Normansrule/riscv-64-instruction-cpu/binary/Zbb/cpopw.md

# `cpopw`: Count Population Word

[← all instructions](../README.md) · extension **Zbb** · format **I-unary** · category *Bit manipulation*

```
rd = number of 1 bits in rs1[31:0]
```

## Encoding

cpopw encoding

```
bit:  31                              0
      0110 0000 0010 ssss s001 dddd d001 1011
```

Fixed bits are `0`/`1`. Letters are filled in by the assembler:
`d` = rd, `s` = rs1, `t` = rs2, `i` = immediate, `h` = shift amount, `c` = CSR address, `z` = 5-bit CSR immediate, `f` = funct3, `m/p/u` = fence fields.

## Example

`cpopw a0, a1` assembles to **`0x6025951b`** = `01100000001001011001010100011011`

example

| field | bits | template | example |
|---|---|---|---|
| `funct12` | 31:20 | `011000000010` | `011000000010` |
| `rs1` | 19:15 | `sssss` | `01011` |
| `funct3` | 14:12 | `001` | `001` |
| `rd` | 11:7 | `ddddd` | `01010` |
| `opcode` | 6:0 | `0011011` | `0011011` |

Try it yourself:

```bash
node tools/rv.mjs encode "cpopw a0, a1"
node tools/rv.mjs decode 6025951b
```

## Control signals from the Control Unit ([`src/Control_Unit.sv`](../../src/Control_Unit.sv))

These are the exact values the RTL produces for the example word above (computed by the
bit-exact twin in `model/core.js`, which `make test` checks against the RTL every cycle).

| signal | value | | signal | value |
|---|---|---|---|---|
| `REGISTER_WRITE_ENABLE` | `1` | | `IS_A_MULTIPLY_DIVIDE_INSTRUCTION` | `0` |
| `MEMORY_READ_ENABLE` | `0` | | `IS_A_BRANCH_INSTRUCTION` | `0` |
| `MEMORY_WRITE_ENABLE` | `0` | | `IS_A_JAL_INSTRUCTION` | `0` |
| `CSR_WRITE_ENABLE` | `0` | | `IS_A_JALR_INSTRUCTION` | `0` |
| `CSR_WRITE_USING_IMMEDIATE` | `0` | | `IMMEDIATE_TYPE_SELECT` | `IMMEDIATE_I` |
| `ALU_INPUT_A_IS_PC` | `0` | | `WRITEBACK_SELECT` | `WRITEBACK_ALU` |
| `ALU_INPUT_B_IS_IMMEDIATE` | `1` | | `ALU_OPERATION` | `ALU_CPOP` |
| `ALU_IS_WORD_OPERATION` | `1` | |  |  |

## Journey through the 6-stage pipeline

| stage | what happens to `cpopw` |
|---|---|
| **FETCH1** | The PC is sent to the instruction memory. At the same time the **GSharePredictor** reads the 2-bit counter at `PC[5:2] XOR GLOBAL_HISTORY_REGISTER` (it does not know yet what instruction this is). |
| **FETCH2** | The 32-bit word arrives from memory. It is not a branch or JAL, so fetching simply continues at `PC + 4`. |
| **DECODE** | **ControlUnit** + **ALUdec** recognise `cpopw` from opcode `0011011`, funct3 `001`, funct12 `011000000010`; the **ImmediateGenerator** builds the I-type immediate. The **RegisterFile** is read for `rs1`, and the forwarding muxes replace a stale value with a newer one from EXECUTE, MEMORY or WRITEBACK. |
| **EXECUTE** | The **ALU** performs `CPOP` on the low 32 bits and sign-extends the result to 64 bits: `rd = number of 1 bits in rs1[31:0]`. This result is one of the two-cycle ones (`EXECUTE_LATE_RESULT`): it is forwarded from MEMORY, so an instruction that needs it right away waits one cycle. |
| **MEMORY** | No memory work. **WriteControl** picks the `WRITEBACK_ALU` value, which can be forwarded back to DECODE. |
| **WRITEBACK** | The **RegisterFile** writes `rd` at the clock edge (ignored if `rd` is `x0`). The instruction is now **retired** and the `instret` counter goes up by one. |

See the whole datapath in the [block diagram](../../docs/ARCHITECTURE.md) and step through a program in the [web simulator](../../web/index.html).
