Normansrule/riscv-64-instruction-cpu/binary/Priv/mret.md

# `mret`: Machine-mode Return

[← all instructions](../README.md) · extension **Priv** · format **SYS** · category *System*

```
return from a trap: pc = mepc, mstatus.MIE = mstatus.MPIE
```

## Encoding

mret encoding

```
bit:  31                              0
      0000 0000 0000 0000 0000 0000 0111 0011
```

Fixed bits are `0`/`1`. Letters are filled in by the assembler:
`d` = rd, `s` = rs1, `t` = rs2, `i` = immediate, `h` = shift amount, `c` = CSR address, `z` = 5-bit CSR immediate, `f` = funct3, `m/p/u` = fence fields.

## Example

`mret` assembles to **`0x30200073`** = `00110000001000000000000001110011`

example

| field | bits | template | example |
|---|---|---|---|
| `funct12` | 31:20 | `000000000000` | `001100000010` |
| `rs1` | 19:15 | `00000` | `00000` |
| `funct3` | 14:12 | `000` | `000` |
| `rd` | 11:7 | `00000` | `00000` |
| `opcode` | 6:0 | `1110011` | `1110011` |

Try it yourself:

```bash
node tools/rv.mjs encode "mret"
node tools/rv.mjs decode 30200073
```

## Control signals from the Control Unit ([`src/Control_Unit.sv`](../../src/Control_Unit.sv))

These are the exact values the RTL produces for the example word above (computed by the
bit-exact twin in `model/core.js`, which `make test` checks against the RTL every cycle).

| signal | value | | signal | value |
|---|---|---|---|---|
| `REGISTER_WRITE_ENABLE` | `0` | | `IS_A_MULTIPLY_DIVIDE_INSTRUCTION` | `0` |
| `MEMORY_READ_ENABLE` | `0` | | `IS_A_BRANCH_INSTRUCTION` | `0` |
| `MEMORY_WRITE_ENABLE` | `0` | | `IS_A_JAL_INSTRUCTION` | `0` |
| `CSR_WRITE_ENABLE` | `0` | | `IS_A_JALR_INSTRUCTION` | `0` |
| `CSR_WRITE_USING_IMMEDIATE` | `0` | | `IMMEDIATE_TYPE_SELECT` | `IMMEDIATE_I` |
| `ALU_INPUT_A_IS_PC` | `0` | | `WRITEBACK_SELECT` | `WRITEBACK_CSR` |
| `ALU_INPUT_B_IS_IMMEDIATE` | `0` | | `ALU_OPERATION` | `ALU_XXX` |
| `ALU_IS_WORD_OPERATION` | `0` | |  |  |

## Journey through the 6-stage pipeline

| stage | what happens to `mret` |
|---|---|
| **FETCH1** | The PC is sent to the instruction memory. At the same time the **GSharePredictor** reads the 2-bit counter at `PC[5:2] XOR GLOBAL_HISTORY_REGISTER` (it does not know yet what instruction this is). |
| **FETCH2** | The 32-bit word arrives from memory. It is not a branch or JAL, so fetching simply continues at `PC + 4`. |
| **DECODE** | **ControlUnit** + **ALUdec** recognise `mret` from opcode `1110011`, funct3 `000`; the **ImmediateGenerator** builds the I-type immediate. No registers are needed. |
| **EXECUTE** | Nothing: on this core ECALL/EBREAK are no-ops; programs finish by writing the `tohost` CSR (`halt`). |
| **MEMORY** | No memory work. **WriteControl** picks the result value. |
| **WRITEBACK** | Nothing to write. The instruction retires (`instret` + 1). |

See the whole datapath in the [block diagram](../../docs/ARCHITECTURE.md) and step through a program in the [web simulator](../../web/index.html).
