Normansrule/riscv-64-instruction-cpu/binary/RV64I/jalr.md

# `jalr`: Jump And Link Register

[← all instructions](../README.md) · extension **RV64I** · format **I** · category *Jump*

```
t = pc + 4; pc = (rs1 + sext(imm)) & ~1; rd = t
```

## Encoding

jalr encoding

```
bit:  31                              0
      iiii iiii iiii ssss s000 dddd d110 0111
```

Fixed bits are `0`/`1`. Letters are filled in by the assembler:
`d` = rd, `s` = rs1, `t` = rs2, `i` = immediate, `h` = shift amount, `c` = CSR address, `z` = 5-bit CSR immediate, `f` = funct3, `m/p/u` = fence fields.

## Example

`jalr ra, 8(t0)` assembles to **`0x008280e7`** = `00000000100000101000000011100111`

example

| field | bits | template | example |
|---|---|---|---|
| `imm[11:0]` | 31:20 | `iiiiiiiiiiii` | `000000001000` |
| `rs1` | 19:15 | `sssss` | `00101` |
| `funct3` | 14:12 | `000` | `000` |
| `rd` | 11:7 | `ddddd` | `00001` |
| `opcode` | 6:0 | `1100111` | `1100111` |

Try it yourself:

```bash
node tools/rv.mjs encode "jalr ra, 8(t0)"
node tools/rv.mjs decode 008280e7
```

## Control signals from the Control Unit ([`src/Control_Unit.sv`](../../src/Control_Unit.sv))

These are the exact values the RTL produces for the example word above (computed by the
bit-exact twin in `model/core.js`, which `make test` checks against the RTL every cycle).

| signal | value | | signal | value |
|---|---|---|---|---|
| `REGISTER_WRITE_ENABLE` | `1` | | `IS_A_MULTIPLY_DIVIDE_INSTRUCTION` | `0` |
| `MEMORY_READ_ENABLE` | `0` | | `IS_A_BRANCH_INSTRUCTION` | `0` |
| `MEMORY_WRITE_ENABLE` | `0` | | `IS_A_JAL_INSTRUCTION` | `0` |
| `CSR_WRITE_ENABLE` | `0` | | `IS_A_JALR_INSTRUCTION` | `1` |
| `CSR_WRITE_USING_IMMEDIATE` | `0` | | `IMMEDIATE_TYPE_SELECT` | `IMMEDIATE_I` |
| `ALU_INPUT_A_IS_PC` | `0` | | `WRITEBACK_SELECT` | `WRITEBACK_PC_ADD_4` |
| `ALU_INPUT_B_IS_IMMEDIATE` | `1` | | `ALU_OPERATION` | `ALU_JALR` |
| `ALU_IS_WORD_OPERATION` | `0` | |  |  |

## Journey through the 6-stage pipeline

| stage | what happens to `jalr` |
|---|---|
| **FETCH1** | The PC is sent to the instruction memory. At the same time the **GSharePredictor** reads the 2-bit counter at `PC[5:2] XOR GLOBAL_HISTORY_REGISTER` (it does not know yet what instruction this is). |
| **FETCH2** | The 32-bit word arrives from memory. It is not a branch or JAL, so fetching simply continues at `PC + 4`. |
| **DECODE** | **ControlUnit** + **ALUdec** recognise `jalr` from opcode `1100111`, funct3 `000`; the **ImmediateGenerator** builds the I-type immediate. The **RegisterFile** is read for `rs1`, and the forwarding muxes replace a stale value with a newer one from EXECUTE, MEMORY or WRITEBACK. |
| **EXECUTE** | The ALU computes `rs1 + imm`, bit 0 is cleared. The target was unknowable in FETCH2 (it lives in a register), so BranchControl **always flushes** (3 bubbles) and FETCH1 restarts at the target. The link value is `PC + 4`. |
| **MEMORY** | No memory work. **WriteControl** picks the `WRITEBACK_PC_ADD_4` value, which can be forwarded back to DECODE. |
| **WRITEBACK** | The **RegisterFile** writes `rd` at the clock edge (ignored if `rd` is `x0`). The instruction is now **retired** and the `instret` counter goes up by one. |

See the whole datapath in the [block diagram](../../docs/ARCHITECTURE.md) and step through a program in the [web simulator](../../web/index.html).
