Normansrule/riscv-64-instruction-cpu/fpga/boards/basys3/basys3.xdc

## =============================================================================
## Digilent Basys 3 (XC7A35T-1CPG236C): the pins Sixfold uses.
## Sites are copied from Digilent's Basys-3-Master.xdc
## (github.com/Digilent/digilent-xdc); check them against it for your board.
## =============================================================================

## 100 MHz oscillator
set_property -dict { PACKAGE_PIN W5  IOSTANDARD LVCMOS33 } [get_ports { clk }];
create_clock -add -name sys_clk_pin -period 10.00 -waveform {0 5} [get_ports { clk }];

## 16 slide switches
set_property -dict { PACKAGE_PIN V17 IOSTANDARD LVCMOS33 } [get_ports { sw[0] }];
set_property -dict { PACKAGE_PIN V16 IOSTANDARD LVCMOS33 } [get_ports { sw[1] }];
set_property -dict { PACKAGE_PIN W16 IOSTANDARD LVCMOS33 } [get_ports { sw[2] }];
set_property -dict { PACKAGE_PIN W17 IOSTANDARD LVCMOS33 } [get_ports { sw[3] }];
set_property -dict { PACKAGE_PIN W15 IOSTANDARD LVCMOS33 } [get_ports { sw[4] }];
set_property -dict { PACKAGE_PIN V15 IOSTANDARD LVCMOS33 } [get_ports { sw[5] }];
set_property -dict { PACKAGE_PIN W14 IOSTANDARD LVCMOS33 } [get_ports { sw[6] }];
set_property -dict { PACKAGE_PIN W13 IOSTANDARD LVCMOS33 } [get_ports { sw[7] }];
set_property -dict { PACKAGE_PIN V2  IOSTANDARD LVCMOS33 } [get_ports { sw[8] }];
set_property -dict { PACKAGE_PIN T3  IOSTANDARD LVCMOS33 } [get_ports { sw[9] }];
set_property -dict { PACKAGE_PIN T2  IOSTANDARD LVCMOS33 } [get_ports { sw[10] }];
set_property -dict { PACKAGE_PIN R3  IOSTANDARD LVCMOS33 } [get_ports { sw[11] }];
set_property -dict { PACKAGE_PIN W2  IOSTANDARD LVCMOS33 } [get_ports { sw[12] }];
set_property -dict { PACKAGE_PIN U1  IOSTANDARD LVCMOS33 } [get_ports { sw[13] }];
set_property -dict { PACKAGE_PIN T1  IOSTANDARD LVCMOS33 } [get_ports { sw[14] }];
set_property -dict { PACKAGE_PIN R2  IOSTANDARD LVCMOS33 } [get_ports { sw[15] }];

## 16 LEDs
set_property -dict { PACKAGE_PIN U16 IOSTANDARD LVCMOS33 } [get_ports { led[0] }];
set_property -dict { PACKAGE_PIN E19 IOSTANDARD LVCMOS33 } [get_ports { led[1] }];
set_property -dict { PACKAGE_PIN U19 IOSTANDARD LVCMOS33 } [get_ports { led[2] }];
set_property -dict { PACKAGE_PIN V19 IOSTANDARD LVCMOS33 } [get_ports { led[3] }];
set_property -dict { PACKAGE_PIN W18 IOSTANDARD LVCMOS33 } [get_ports { led[4] }];
set_property -dict { PACKAGE_PIN U15 IOSTANDARD LVCMOS33 } [get_ports { led[5] }];
set_property -dict { PACKAGE_PIN U14 IOSTANDARD LVCMOS33 } [get_ports { led[6] }];
set_property -dict { PACKAGE_PIN V14 IOSTANDARD LVCMOS33 } [get_ports { led[7] }];
set_property -dict { PACKAGE_PIN V13 IOSTANDARD LVCMOS33 } [get_ports { led[8] }];
set_property -dict { PACKAGE_PIN V3  IOSTANDARD LVCMOS33 } [get_ports { led[9] }];
set_property -dict { PACKAGE_PIN W3  IOSTANDARD LVCMOS33 } [get_ports { led[10] }];
set_property -dict { PACKAGE_PIN U3  IOSTANDARD LVCMOS33 } [get_ports { led[11] }];
set_property -dict { PACKAGE_PIN P3  IOSTANDARD LVCMOS33 } [get_ports { led[12] }];
set_property -dict { PACKAGE_PIN N3  IOSTANDARD LVCMOS33 } [get_ports { led[13] }];
set_property -dict { PACKAGE_PIN P1  IOSTANDARD LVCMOS33 } [get_ports { led[14] }];
set_property -dict { PACKAGE_PIN L1  IOSTANDARD LVCMOS33 } [get_ports { led[15] }];

## Seven-segment display: segments a..g and the decimal point (active low), digit anodes (active low)
set_property -dict { PACKAGE_PIN W7  IOSTANDARD LVCMOS33 } [get_ports { seg[0] }];
set_property -dict { PACKAGE_PIN W6  IOSTANDARD LVCMOS33 } [get_ports { seg[1] }];
set_property -dict { PACKAGE_PIN U8  IOSTANDARD LVCMOS33 } [get_ports { seg[2] }];
set_property -dict { PACKAGE_PIN V8  IOSTANDARD LVCMOS33 } [get_ports { seg[3] }];
set_property -dict { PACKAGE_PIN U5  IOSTANDARD LVCMOS33 } [get_ports { seg[4] }];
set_property -dict { PACKAGE_PIN V5  IOSTANDARD LVCMOS33 } [get_ports { seg[5] }];
set_property -dict { PACKAGE_PIN U7  IOSTANDARD LVCMOS33 } [get_ports { seg[6] }];
set_property -dict { PACKAGE_PIN V7  IOSTANDARD LVCMOS33 } [get_ports { dp }];
set_property -dict { PACKAGE_PIN U2  IOSTANDARD LVCMOS33 } [get_ports { an[0] }];
set_property -dict { PACKAGE_PIN U4  IOSTANDARD LVCMOS33 } [get_ports { an[1] }];
set_property -dict { PACKAGE_PIN V4  IOSTANDARD LVCMOS33 } [get_ports { an[2] }];
set_property -dict { PACKAGE_PIN W4  IOSTANDARD LVCMOS33 } [get_ports { an[3] }];

## Five push buttons (pressed = 1)
set_property -dict { PACKAGE_PIN U18 IOSTANDARD LVCMOS33 } [get_ports { btnC }];
set_property -dict { PACKAGE_PIN T18 IOSTANDARD LVCMOS33 } [get_ports { btnU }];
set_property -dict { PACKAGE_PIN W19 IOSTANDARD LVCMOS33 } [get_ports { btnL }];
set_property -dict { PACKAGE_PIN T17 IOSTANDARD LVCMOS33 } [get_ports { btnR }];
set_property -dict { PACKAGE_PIN U17 IOSTANDARD LVCMOS33 } [get_ports { btnD }];

## USB-UART (FT2232HQ): RsRx is what the PC sends (an FPGA input), RsTx what it receives
set_property -dict { PACKAGE_PIN B18 IOSTANDARD LVCMOS33 } [get_ports { RsRx }];
set_property -dict { PACKAGE_PIN A18 IOSTANDARD LVCMOS33 } [get_ports { RsTx }];

## The switches, buttons and UART input are asynchronous: they are synchronized in the design
set_false_path -from [get_ports { sw[*] btnC btnU btnL btnR btnD RsRx }]
set_false_path -to [get_ports { led[*] seg[*] dp an[*] RsTx }]

## Configuration bank voltage, and a compressed bitstream (faster to load)
set_property CONFIG_VOLTAGE 3.3 [current_design]
set_property CFGBVS VCCO [current_design]
set_property BITSTREAM.GENERAL.COMPRESS TRUE [current_design]
