Normansrule/riscv-64-instruction-cpu/fpga/boards/arty_a7/arty_a7_100t.xdc

## =============================================================================
## Arty A7-100T (XC7A100T-1CSG324C): the pins Sixfold uses.
## Sites are copied from Digilent's Arty-A7-100-Master.xdc
## (github.com/Digilent/digilent-xdc); check them against it for your board.
## =============================================================================

## 100 MHz oscillator
set_property -dict { PACKAGE_PIN E3  IOSTANDARD LVCMOS33 } [get_ports { CLK100MHZ }];
create_clock -add -name sys_clk_pin -period 10.00 -waveform {0 5} [get_ports { CLK100MHZ }];

## RESET button (red, active low)
set_property -dict { PACKAGE_PIN C2  IOSTANDARD LVCMOS33 } [get_ports { ck_rst }];

## Green LEDs
set_property -dict { PACKAGE_PIN H5  IOSTANDARD LVCMOS33 } [get_ports { led[0] }];
set_property -dict { PACKAGE_PIN J5  IOSTANDARD LVCMOS33 } [get_ports { led[1] }];
set_property -dict { PACKAGE_PIN T9  IOSTANDARD LVCMOS33 } [get_ports { led[2] }];
set_property -dict { PACKAGE_PIN T10 IOSTANDARD LVCMOS33 } [get_ports { led[3] }];

## RGB LEDs, green channel only
set_property -dict { PACKAGE_PIN F6  IOSTANDARD LVCMOS33 } [get_ports { led0_g }];
set_property -dict { PACKAGE_PIN J4  IOSTANDARD LVCMOS33 } [get_ports { led1_g }];
set_property -dict { PACKAGE_PIN J2  IOSTANDARD LVCMOS33 } [get_ports { led2_g }];
set_property -dict { PACKAGE_PIN H6  IOSTANDARD LVCMOS33 } [get_ports { led3_g }];

## Switches
set_property -dict { PACKAGE_PIN A8  IOSTANDARD LVCMOS33 } [get_ports { sw[0] }];
set_property -dict { PACKAGE_PIN C11 IOSTANDARD LVCMOS33 } [get_ports { sw[1] }];
set_property -dict { PACKAGE_PIN C10 IOSTANDARD LVCMOS33 } [get_ports { sw[2] }];
set_property -dict { PACKAGE_PIN A10 IOSTANDARD LVCMOS33 } [get_ports { sw[3] }];

## Buttons
set_property -dict { PACKAGE_PIN D9  IOSTANDARD LVCMOS33 } [get_ports { btn[0] }];
set_property -dict { PACKAGE_PIN C9  IOSTANDARD LVCMOS33 } [get_ports { btn[1] }];
set_property -dict { PACKAGE_PIN B9  IOSTANDARD LVCMOS33 } [get_ports { btn[2] }];
set_property -dict { PACKAGE_PIN B8  IOSTANDARD LVCMOS33 } [get_ports { btn[3] }];

## USB-UART (FT2232HQ channel B): uart_rxd_out is what the PC receives (an FPGA output)
set_property -dict { PACKAGE_PIN D10 IOSTANDARD LVCMOS33 } [get_ports { uart_rxd_out }];
set_property -dict { PACKAGE_PIN A9  IOSTANDARD LVCMOS33 } [get_ports { uart_txd_in }];

## The buttons, switches, reset and UART input are asynchronous: they are synchronized in the design
set_false_path -from [get_ports { ck_rst btn[*] sw[*] uart_txd_in }]
set_false_path -to [get_ports { led[*] led0_g led1_g led2_g led3_g uart_rxd_out }]

## Configuration (the Arty's 16 MB Quad-SPI flash)
set_property CONFIG_VOLTAGE 3.3 [current_design];
set_property CFGBVS VCCO [current_design];
set_property BITSTREAM.CONFIG.SPI_BUSWIDTH 4 [current_design];
