Normansrule/riscv-64-instruction-cpu/(commit log)

2026-09-22 RV64IM 6-stage pipeline with gshare predictor, cycle-exact model, interactive simulator, docs
2026-09-26 Performance edition: BTB, return address stack, precise load stalls, 6-bit gshare, Kogge-Stone adders, iterative M unit (7.5 -> 207 MHz logic-only, CPI to 1.02); baseline build kept; both verified cy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
    [ALU.sv, Branch_Comparator.sv, Branch_Control_Unit.sv, Branch_Target_Buffer.sv, Control_Unit.sv, Iterative_Multiply_Divide_Unit.sv, Parallel_Prefix_Adder.sv, Prefix_Negate.sv]
2026-09-26 Instruction cache with next-line prefetch, write-through data cache, tournament branch predictor; prefix incrementers; ASAP7 7nm timing (1.34 GHz logic-only) next to sky130 (200 MHz); docs and site u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
2026-09-26 Rename to Sixfold (sixfold-cpu): six-bar logo, site and docs; split 64-bit counters (7nm 1.37 GHz logic-only); Inside-the-caches interactive section; updated measurements
2026-09-27 Machine-mode traps (ecall, ebreak, mret, mtvec/mepc/mcause/mstatus/mscratch) with a system-call demo; 2-way set-associative instruction and data caches with LRU; cache-conflict program; 864-case self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
2026-09-28 Predictor arena (BHT, gshare, tournament, perceptron, TAGE) with challenge program and animated site race; next-line data prefetch; cache victim fix in model; MODERN_CPUS.md with sources; scroll-reve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
    [Data_Cache.sv]
2026-09-28 Detailed README figures (front end, cache lookup, memory hierarchy, clock roadmap); 7 nm critical path 729 ps -> 522 ps (1.37 -> 1.92 GHz)
    Figures (tools/diagrams.mjs, make diagrams, checked in CI):
    - branch_prediction.svg: BTB, BHT, gshare with history, chooser, RAS, training and repair
    - cache.svg: tag/set/offset split, two ways, LRU, refill timeline, prefetch, write-through
    - memory_hierarchy.svg: Sixfold next to a typical desktop core
    - clock_roadmap.svg: measured periods against 2.5 GHz and 5 GHz, and the steps between
    - block diagram updated: caches, tournament + BTB, RAS, traps, operand muxes in DECODE
    Timing (each step verified cycle-exact on all 76 runs):
    - PC + 4 registered from F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
2026-09-28 Zba + Zbb (32 instructions), hardware performance counters, animated README, bit-tricks and multiplier explorers
    CPU:
    - Zba (sh1add..sh3add, add.uw, shNadd.uw, slli.uw) and Zbb (andn orn xnor, clz ctz cpop (+W),
    min(u) max(u), rol ror rori (+W), sext.b/h, zext.h, rev8, orc.b): 104 instructions in total
    - operands prepared in DECODE; the value forwarded from EXECUTE takes a separate short path;
    the adder enters the ALU result mux last; cpop and min/max get a 2-cycle latency
    - LeadingZeroCounter and PopulationCount tree modules (the divider reuses the counter)
    - hpmcounter3..8 count L F R K I D, the terms of the cycle equation
    - timing flow: synth -noshare (resource sharing had merged shif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
2026-09-29 FPGA computer (ULX3S, Arty A7): boot firmware, UART loader, device registers; Zbs completes B; cpop split over two stages
    - fpga/: SixfoldSystem (block-RAM main memory, UART with queues, LEDs, buttons,
    memory-mapped device registers, reset/boot control), boot firmware (bios.s),
    whole-system testbench, ULX3S (open flow, 25 MHz, 43% of an ECP5-85F) and
    Arty A7-100T (Vivado) builds; tools/fpga_sim.mjs checks every program's
    cycle count over the simulated UART against the model
    - Zbs: bset/bclr/binv as DECODE operand preparation (early path only, with a
    one-cycle SINGLE_BIT_HAZARD), bext in the ALU; 112 instructions
    - cpop: nibble lookups + quarter counts in EXECUTE, final add in MEMOR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
    [ALU.sv, ALUdec.sv, ALUop_pkg.sv, Control_Unit.sv, Data_Cache.sv, Main_Memory.sv, Parallel_Prefix_Adder.sv, Population_Count.sv]
2026-09-30 Precise timer and external interrupts, wfi, machine timer, interrupt-driven FPGA example, learning chapter 9
    - interrupts taken in DECODE: a pseudo-instruction replaces the DECODE instruction
    and traps in EXECUTE (mepc = replaced PC, mcause = 2^63 + 7 / 11); 4 cycles,
    new X term in the cycle equation and hpmcounter9; decision uses registered
    signals only
    - mie / mip CSRs, wfi (no-op), memory-mapped MTIME / MTIMECMP in simulation and
    on the FPGA; UART receive drives the external interrupt line on the FPGA
    - programs/21_timer_interrupts.s, tests/interrupt_stress.s (388 interrupts on every
    kind of instruction, checksum unchanged), fpga/examples/interrupt_echo.s
    (checked with typed i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
    [Control_Status_Register_File.sv, Riscv64.sv, Riscv64_top.sv, Sixfold_System.sv, const_pkg.sv, gen_selfcheck.py]
2026-09-30 A tiny preemptive operating system: three tasks, timer-driven context switches
    - programs/22_multitasking.s: round-robin kernel, task control blocks, mscratch
    swap, save/restore of all 31 registers and mepc; cycle-exact on the RTL and
    the FPGA system
    - multitasking diagram from a real trace (timeline, TCB ring, the 8 steps of a
    switch, cost per switch); README, chapter 9, lab 22, site
    Claude-Session: https://claude.ai/code/session_01KgBuX9VrFvXubrizq51vMb
2026-10-02 Web pages: live operating-system section, lab with run-to-end, trap registers, full predictor state, timelines
    Site: new "Three programs, one CPU" section (site/os.js) that replays programs/22_multitasking.s with a
    quantum slider and the task control blocks read from memory; interrupt bubbles in the dashboard and the
    race; 3D view captions for interrupts, traps and mret; race verdict uses the current 244 MHz clock;
    FPGA board commands; phone layout fixes.
    Lab: the cycle equation includes X (interrupts), so programs 21 and 22 check out; "To the end" and an
    exponential speed slider up to about 30,000 cycles per second; only the last 64 cycle records are kept;
    BHT, chooser, BTB and RAS shown ne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
2026-10-02 Basys 3 board: 16 switches, 16 LEDs, 5 buttons, seven-segment display; a hands-on calculator
    - fpga/boards/basys3: top (MMCM 100 -> 20 MHz, synchronizers, left+right reset), XDC from Digilent's
    master file, Vivado script; make fpga-basys3 PROG=calculator
    - System: LEDS is 16 bits (byte-lane stores), new SWITCHES (0x68) and DISPLAY (0x70) registers,
    fpga/rtl/Seven_Segment_Display.sv multiplexes the four digits
    - fpga/examples/calculator.s: A and B on the switches; up/down/left/right add, subtract, multiply,
    divide; answer in decimal on the digits, binary on the LEDs, a sentence on the UART; centre = a light
    painter driven by the buttons; software debouncing, decimal conversion and seg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
    [Carry_Save_Multiplier.sv, Seven_Segment_Display.sv, Sixfold_System.sv, arty_a7_top.sv, basys3.xdc, basys3_top.sv]
